knordestmusic/Wireless-CV-module---V1/(commit log)

2025-04-02 Rename Receiver Module Schematic.png to receiver-schematic.png
2025-04-02 Rename Sender Module Schematic.png to sender-schematic.png
